KULeuven-COSIC/jitter_pipeline_trng/math_model/simulation_data/readme.md

# Stochastic Model Simulation Data

This folder contains the results from simulating the stochastic model.

## Folder structure:

- *m5/*: Contains jitter measurement simulation results.
- *h_vs_res_fnoise30.csv*: Contains simulated data capturing the resolution - entropy trade off.
