KULeuven-COSIC/jitter_pipeline_trng/math_model/simulation_data/m5/readme.md

# Jitter Measurement Simulation

Measurement *m5* is simulated for different jitter strength values.

## Data Format

| Column 0 | Column 1 | Column 2 | Column 3 | Column 4 | Column 5 | Column 6 | Column 7 | Column 8 | Column 9 | Column 10 |
| --- | --- | --- | --- | --- | --- | --- | --- | --- | --- | --- |
| DC0 configuration | DC1 configuration | VDL0 configuration | VDL1 configuration | DC0 period | DC1 period | VDL0 period | VDL1 period | Mean count | Variance count | Noise strength |
| Unit: - | Unit: - | Unit: - | Unit: - | Unit: ps | Unit: ps | Unit: ps | Unit: ps |  Unit: - | Unit: - | Unit: fs |
