KULeuven-COSIC/jitter_pipeline_trng/measurements/stat_tests/readme.md

# NIST SP800-90B IID Entropy Assessment

Statistical test results for different configurations and supply voltages.
