KULeuven-COSIC/jitter_pipeline_trng/measurements/m5/readme.md

# On-chip Jitter Measurement

Measure jitter strength experiment, using the TRNG hardware.

## Measurement Conditions:

The measurements are performed with:
- **Chip number**: 0, 1, 2, 3, 4, and 5

## Data Format

| Column 0 | Column 1 | Column 2 | Column 3 | Column 4 | Column 5 | Column 6 | Column 7 | Column 8 | Column 9 |
| --- | --- | --- | --- | --- | --- | --- | --- | --- | --- |
| DC0 configuration | DC1 configuration | VDL0 configuration | VDL1 configuration | DC0 period | DC1 period | VDL0 period | VDL1 period | Mean count | Variance count |
| Unit: - | Unit: - | Unit: - | Unit: - | Unit: ps | Unit: ps | Unit: ps | Unit: ps |  Unit: - | Unit: - |
