KULeuven-COSIC/jitter_pipeline_trng/measurements/m6/readme.md

# TRNG Configuration Optimization

Find an optimized configuration for the ASIC, within the constraints set by the stochastic model.

## Measurement Conditions:

The measurements are performed with the following operating conditions:
- **Temperature**: 20 °C
- **Supply voltage**: 0.8 V, 0.9 V, and 1.0 V
- **Chip number**: 0, 1, 2, 3, and 4

## Data Format

| Column 0 | Column 1 | Column 2 | Column 3 | Column 4 | Column 5 | Column 6 | Column 7 |
| --- | --- | --- | --- | --- | --- | --- | --- |
| DC0 configuration | DC1 configuration | VDL0 configuration | VDL1 configuration | DC0 period | DC1 period | VDL0 period | VDL1 period |
| Unit: - | Unit: - | Unit: - | Unit: - | Unit: ps | Unit: ps | Unit: ps | Unit: ps |
