KULeuven-COSIC/jitter_pipeline_trng/measurements/m7/readme.md

# Random Count Readout

Readout a small amount of random samples, using an optimized configuration.

## Measurement Conditions:

The measurements are performed with the following operating conditions:
- **Temperature**: 20 °C
- **Supply voltage**: 0.8 V, 0.9 V, and 1.0 V
- **Chip number**: 0, 1, 2, 3, and 4

## Data Format

A list of raw count values.
