KULeuven-COSIC/jitter_pipeline_trng/measurements/readout/readme.md

# Measurement scripts

This folder contains the following measurement scripts:
- **m0_read_freqs.py**: Read all RO frequencies.
- **m5_jitter_strength.py**: Measure jitter strength experiment.
- **m6_get_candidates.py**: Find an optimized configuration for the ASIC.
- **m7_read_bits.py**: Readout a small amount of random samples.
