KULeuven-COSIC/jitter_pipeline_trng/measurements/m0/readme.md

# RO Frequency Measurement

Read all RO frequencies.

## Measurement Conditions:

The measurements are performed with:
- **Chip number**: 0, 1, 2, 3, 4, and 5
- **Frequency scaler**: `conf_ro_sel = 0`

## Data Format

| Column 0 | Column 1 | Column 2 | Column 3 | Column 4 |
| --- | --- | --- | --- | --- |
| RO configuration | DC0 period | DC1 period | VDL0 period | VDL1 period |
| Unit: - | Unit: ns | Unit: ns | Unit: ps | Unit: ps |
