KULeuven-COSIC/jitter_pipeline_trng/measurements/stat_tests/iid_results.txt

NIST SP800-90B entropy assessment IID

| Chip | Conf                    | Temp | Supply | nb bits   | H_origi | H_bitst | ChiS | Leng | IIDP |

| 0000 | 17478 13892 44034 19462 | 0020 | 0000.9 | 001048576 | 4.71182 | 0.87548 | Fail | Pass | Fail |
| 0000 | 29038 18274 08802 03488 | 0020 | 0000.9 | 001048576 | 1.12625 | 0.16969 | Fail | Fail | Fail |
| 0000 | 41296 00786 33256 62592 | 0020 | 0000.9 | 001048576 | 7.56673 | 0.96453 | Pass | Pass | Pass |
| 0000 | 08910 62245 17569 35105 | 0020 | 0000.9 | 001048576 | 4.77728 | 0.93605 | Fail | Fail | Fail |
| 0000 | 53354 48800 12806 10786 | 0020 | 0000.9 | 001048576 | 7.49407 | 0.95119 | Pass | Pass | Pass |
| 0000 | 49365 02217 12592 38980 | 0020 | 0000.9 | 001048576 | 6.11269 | 0.83397 | Fail | Pass | Fail |
| 0000 | 00799 63233 60974 63709 | 0020 | 0000.9 | 001048576 | 1.79305 | 0.31232 | Fail | Fail | Fail |
| 0000 | 28937 16449 17486 00854 | 0020 | 0000.9 | 001048576 | 7.64800 | 0.98895 | Pass | Pass | Pass |
| 0000 | 24839 04290 12485 44416 | 0020 | 0000.9 | 001048576 | 7.46725 | 0.95524 | Pass | Pass | Fail |
| 0000 | 53387 02037 41664 19462 | 0020 | 0000.9 | 001048576 | 7.47545 | 0.94738 | Pass | Pass | Pass |
| 0000 | 13856 08215 00846 18954 | 0020 | 0000.9 | 001048576 | 7.56235 | 0.97071 | Pass | Pass | Fail |
| 0000 | 24928 24080 15168 24072 | 0020 | 0000.9 | 001048576 | 7.40528 | 0.93242 | Pass | Pass | Pass |
| 0000 | 07450 02472 25729 35168 | 0020 | 0000.9 | 001048576 | 7.17819 | 0.91466 | Pass | Pass | Pass |
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
| 0001 | 41231 04277 00160 00192 | 0020 | 0001.0 | 001048576 | 6.16136 | 0.81352 | Fail | Pass | Fail |
| 0001 | 57371 41487 00222 33536 | 0020 | 0001.0 | 001048576 | 7.49199 | 0.95877 | Pass | Pass | Pass |
