KULeuven-COSIC/jitter_pipeline_trng/measurements/m5/m5_chip0.csv

confDC0 | confDC1 | confVDL0 | confVDL1 | perDC0 [ps] | perDC1 [ps] | perVDL0 [ps] | perVDL1 [ps] | n | cntMean | cntVar
0 | 0 | 0 | 65376 | 18757.799530597058 | 18232.806588025815 | 448.8232224378738 | 171.2256470602989 | 1 | 9.10455322265625 | 0.10555421933531761
0 | 0 | 0 | 65376 | 18769.618513002635 | 18241.941769192228 | 448.4933426769447 | 171.1826217876485 | 2 | 12.397689819335938 | 0.2697450292762369
0 | 0 | 0 | 65376 | 18779.299673333713 | 18250.069618490674 | 448.5166701798282 | 171.20256636659542 | 4 | 18.779693603515625 | 0.31242700573056936
0 | 0 | 0 | 65376 | 18773.920018333905 | 18241.941769192228 | 448.4761555432682 | 171.21661085371608 | 8 | 31.723434448242188 | 0.6168556117918342
0 | 0 | 0 | 65376 | 18784.682412290756 | 18241.941769192228 | 448.44055781363335 | 171.21446377655175 | 1 | 9.17877197265625 | 0.150993462651968
0 | 0 | 0 | 65376 | 18779.299673333713 | 18240.92629703852 | 448.5516659845126 | 171.22591547706074 | 2 | 12.588897705078125 | 0.2447217097505927
0 | 0 | 0 | 65376 | 18788.990825688074 | 18255.153203342616 | 448.53631627504603 | 171.27057384632272 | 4 | 18.822372436523438 | 0.33794002584181726
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
