KULeuven-COSIC/jitter_pipeline_trng/measurements/m5/m5_chip1.csv

confDC0 | confDC1 | confVDL0 | confVDL1 | perDC0 [ps] | perDC1 [ps] | perVDL0 [ps] | perVDL1 [ps] | n | cntMean | cntVar
0 | 0 | 0 | 65376 | 17512.693068248624 | 17057.782404997397 | 386.87496458053914 | 155.5979752509568 | 1 | 9.517807006835938 | 0.2500491214450449
0 | 0 | 0 | 65376 | 17501.468781712334 | 17053.34374186833 | 386.6362247275859 | 156.00065508087582 | 2 | 13.903228759765625 | 0.22293513175100088
0 | 0 | 0 | 65376 | 17508.014533019876 | 17059.558517284466 | 386.5979077370313 | 155.41886208615483 | 4 | 20.602264404296875 | 0.3167209466919303
0 | 0 | 0 | 65376 | 17508.950040074807 | 17045.35996670828 | 386.680937484143 | 155.6908305474836 | 8 | 33.793304443359375 | 0.5805984800681472
0 | 0 | 0 | 65376 | 17502.403589360114 | 17056.894487533184 | 386.6585798132314 | 156.70513677028075 | 1 | 9.470779418945312 | 0.24939029826782644
0 | 0 | 0 | 65376 | 17502.403589360114 | 17056.006662502605 | 386.9571994728464 | 156.94005213773826 | 2 | 13.921539306640625 | 0.21845329459756613
0 | 0 | 0 | 65376 | 17516.437697118727 | 17065.77782407166 | 386.8092018282779 | 156.17076602218265 | 4 | 20.615768432617188 | 0.3138986953999847
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
