KULeuven-COSIC/jitter_pipeline_trng/measurements/m5/m5_chip2.csv

confDC0 | confDC1 | confVDL0 | confVDL1 | perDC0 [ps] | perDC1 [ps] | perVDL0 [ps] | perVDL1 [ps] | n | cntMean | cntVar
12288 | 12288 | 0 | 65376 | 15468.277945619335 | 15338.669662500584 | 433.08455114132744 | 174.68617741245032 | 1 | 7.030853271484375 | 0.04482444282621145
12288 | 12288 | 0 | 65376 | 15460.250058976173 | 15350.166299714245 | 432.74710152679114 | 175.06377636200935 | 2 | 7.3525238037109375 | 0.2584021387156099
12288 | 12288 | 0 | 65376 | 15463.898065125059 | 15351.604591239167 | 432.7071000252219 | 174.65954766972249 | 4 | 8.713409423828125 | 0.3275338103994727
12288 | 12288 | 0 | 65376 | 15466.087695284845 | 15345.853041727158 | 433.2689406410444 | 175.05563978541153 | 8 | 11.3651123046875 | 0.47081898152828217
12288 | 12288 | 0 | 65376 | 15469.008166926309 | 15345.134401048983 | 433.2477450438563 | 174.71728676338464 | 1 | 7.0687713623046875 | 0.07884288742206991
12288 | 12288 | 0 | 65376 | 15467.547793249942 | 15347.290525033957 | 433.04277037420775 | 175.02562516591593 | 2 | 7.3344879150390625 | 0.2555036989506334
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
