KULeuven-COSIC/jitter_pipeline_trng/measurements/m5/m5_chip3.csv

confDC0 | confDC1 | confVDL0 | confVDL1 | perDC0 [ps] | perDC1 [ps] | perVDL0 [ps] | perVDL1 [ps] | n | cntMean | cntVar
8192 | 1 | 0 | 61567 | 14661.297539149888 | 13975.348658677016 | 381.3092377422602 | 147.85395631612266 | 1 | 11.3209228515625 | 0.2179313749074936
8192 | 1 | 0 | 61567 | 14664.578205415082 | 13979.522184300342 | 381.4654896432259 | 147.9045427114539 | 2 | 15.593460083007812 | 0.2568291777279228
8192 | 1 | 0 | 61567 | 14666.547309999105 | 13990.265562291863 | 381.7227850106707 | 147.8270755249828 | 4 | 24.501144409179688 | 0.33450186415575445
8192 | 1 | 0 | 61567 | 14656.707071610681 | 13979.522184300342 | 381.4304106010835 | 147.68889061160544 | 8 | 42.205108642578125 | 0.836439966224134
8192 | 1 | 0 | 61567 | 14658.674062807551 | 13974.156680455457 | 381.3394127922336 | 147.7278413873289 | 1 | 11.359771728515625 | 0.23033603187650442
8192 | 1 | 0 | 61567 | 14662.609629497047 | 13978.32949407047 | 381.4472832590647 | 147.80480455827706 | 2 | 15.484664916992188 | 0.2553190344478935
8192 | 1 | 0 | 61567 | 14664.578205415082 | 13988.473852721452 | 381.4042165372157 | 147.61789993175015 | 4 | 24.514480590820312 | 0.3297463671769947
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
