KULeuven-COSIC/jitter_pipeline_trng/measurements/m5/m5_chip4.csv

confDC0 | confDC1 | confVDL0 | confVDL1 | perDC0 [ps] | perDC1 [ps] | perVDL0 [ps] | perVDL1 [ps] | n | cntMean | cntVar
8192 | 1 | 0 | 61671 | 15559.354226020892 | 14967.341159274654 | 431.8864189329896 | 172.2136294095976 | 1 | 10.434127807617188 | 0.24566085427068174
8192 | 1 | 0 | 61671 | 15562.310030395138 | 14976.234003656307 | 432.1461447362521 | 172.4889404521518 | 2 | 13.215484619140625 | 0.2055195039138198
8192 | 1 | 0 | 61671 | 15568.22500950209 | 14984.452167550759 | 431.83177959289105 | 172.7922817197599 | 4 | 19.580413818359375 | 0.30548430141061544
8192 | 1 | 0 | 61671 | 15556.399544246107 | 14975.549563548284 | 431.68614225302014 | 172.51963537537026 | 8 | 32.40142822265625 | 0.4923893176019192
8192 | 1 | 0 | 61671 | 15560.8319878431 | 14985.137421685646 | 431.75951753825393 | 172.3960141839494 | 1 | 10.26361083984375 | 0.1941201649606228
8192 | 1 | 0 | 61671 | 15562.310030395138 | 14983.081847279378 | 432.1444349930434 | 172.771054099569 | 2 | 13.2911376953125 | 0.22062824666500092
8192 | 1 | 0 | 61671 | 15566.745843230403 | 14992.67935578331 | 431.6474738453351 | 173.99837301326014 | 4 | 19.66510009765625 | 0.3168581686913967
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
