KULeuven-COSIC/jitter_pipeline_trng/measurements/m6/m6_chip0_temp20_sup0.9_0.csv

confDC0 [-] | confDC1 [-] | confVDL0 [-] | confVDL1 [-] | perDC0 [ps] | perDC1 [ps] | perVDL0 [ps] | perVDL1 [ps]
17593 | 07656 | 26338 | 23468 | 2236.7 | 2303.9 | 180.49 | 165.80
09974 | 13223 | 61252 | 31142 | 2237.2 | 2300.3 | 180.16 | 165.81
32067 | 39464 | 52840 | 07423 | 2231.3 | 2300.8 | 180.24 | 165.56
34915 | 13254 | 59104 | 37375 | 2236.3 | 2301.9 | 180.40 | 165.81
17802 | 42820 | 50398 | 47718 | 2238.8 | 2301.0 | 180.51 | 165.90
33748 | 11094 | 36212 | 48969 | 2236.7 | 2303.1 | 179.98 | 165.57
18250 | 61851 | 15526 | 57113 | 2237.6 | 2306.4 | 180.42 | 165.78
23605 | 07847 | 56355 | 23971 | 2236.8 | 2300.3 | 180.46 | 165.75
32067 | 15602 | 40049 | 63651 | 2231.1 | 2302.2 | 180.46 | 165.74
29773 | 23593 | 34291 | 52908 | 2233.9 | 2302.4 | 180.51 | 165.81
29813 | 43378 | 56482 | 32596 | 2235.0 | 2301.1 | 180.58 | 165.78
08185 | 14424 | 11686 | 55730 | 2237.6 | 2300.6 | 180.68 | 165.86
11597 | 09686 | 56343 | 59099 | 2239.8 | 2304.9 | 171.33 | 156.98
24388 | 48919 | 32530 | 54949 | 2230.0 | 2294.8 | 180.60 | 165.76
13438 | 24194 | 50727 | 36095 | 2240.3 | 2304.8 | 180.46 | 165.59
11597 | 10645 | 27701 | 54691 | 2240.2 | 2305.0 | 180.51 | 165.70
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
