KULeuven-COSIC/jitter_pipeline_trng/hardware/dc_branch/dc_branch.cir

* Top cell name: dc_branch

.SUBCKT nand2 in0 in1 out vdd vss
    Mm1 net9 in1 vss vss n_mos l=30n w=200n m=1 nf=1
    Mm0 out in0 net9 vss n_mos l=30n w=200n m=1 nf=1
    Mm3 out in1 vdd vdd p_mos l=30n w=100n m=1 nf=1
    Mm2 out in0 vdd vdd p_mos l=30n w=100n m=1 nf=1
.ENDS

.SUBCKT nand3_r in0 in1 in2 out rst vdd vss
    Mm3 out rst vss vss n_mos l=30n w=300n m=1 nf=1
    Mm2 net6 in2 vss vss n_mos l=30n w=300n m=1 nf=1
    Mm1 net7 in1 net6 vss n_mos l=30n w=300n m=1 nf=1
    Mm0 out in0 net7 vss n_mos l=30n w=300n m=1 nf=1
    Mm7 net21 rst vdd vdd p_mos l=30n w=200n m=1 nf=1
    Mm6 out in2 net21 vdd p_mos l=30n w=200n m=1 nf=1
    Mm5 out in1 net21 vdd p_mos l=30n w=200n m=1 nf=1
    Mm4 out in0 net21 vdd p_mos l=30n w=200n m=1 nf=1
.ENDS

.SUBCKT nand3 in0 in1 in2 out vdd vss
    Mm4 net016 in2 vss vss n_mos l=30n w=300n m=1 nf=1
    Mm1 net3 in1 net016 vss n_mos l=30n w=300n m=1 nf=1
    Mm0 out in0 net3 vss n_mos l=30n w=300n m=1 nf=1
    Mm5 out in2 vdd vdd p_mos l=30n w=100n m=1 nf=1
    Mm3 out in1 vdd vdd p_mos l=30n w=100n m=1 nf=1
    Mm2 out in0 vdd vdd p_mos l=30n w=100n m=1 nf=1
.ENDS

.SUBCKT inv_dh in out vdd vss
    Mm0 out in vss vss n_mos l=30n w=200n m=1 nf=1
    Mm1 out in vdd vdd p_mos l=30n w=100n m=1 nf=1
.ENDS

.SUBCKT dff_st_ar_dh clk q q' rst rst' vdd vss
    Xi5 q n1 q' vdd vss nand2
    Xi4 n0 q' q vdd vss nand2
    Xi2 n3 n0 n2 vdd vss nand2
    Xi6 clk n0 n3 n1 rst vdd vss nand3_r
    Xi7 clk n2 rst' n0 vdd vss nand3
    Xi8 n1 n3 vdd vss inv_dh
.ENDS

.SUBCKT first_edge edge out out' rst rst' vdd vss
    Xi0 edge out out' rst rst' vdd vss dff_st_ar_dh
.ENDS

.SUBCKT inv in out vdd vss
    Mm0 out in vss vss n_mos l=30n w=100n m=1 nf=1
    Mm1 out in vdd vdd p_mos l=30n w=100n m=1 nf=1
.ENDS

.SUBCKT mux2 in0 in1 out sel vdd vss
    Xi2 in0 net7 net9 vdd vss nand2
    Xi1 in1 sel net10 vdd vss nand2
    Xi0 net10 net9 out vdd vss nand2
    Xi3 sel net7 vdd vss inv
.ENDS

.SUBCKT mux4 in<0> in<1> in<2> in<3> out sel<0> sel<1> vdd vss
    Xi2 in<2> in<3> net5 sel<0> vdd vss mux2
    Xi1 in<0> in<1> net6 sel<0> vdd vss mux2
    Xi0 net6 net5 out sel<1> vdd vss mux2
.ENDS

.SUBCKT nor2 in0 in1 out vdd vss
    Mm1 out in1 vss vss n_mos l=30n w=100n m=1 nf=1
    Mm0 out in0 vss vss n_mos l=30n w=100n m=1 nf=1
    Mm3 net5 in1 vdd vdd p_mos l=30n w=200n m=1 nf=1
    Mm2 out in0 net5 vdd p_mos l=30n w=200n m=1 nf=1
.ENDS

.SUBCKT enable_n edge en rst rst' rst_glob rst_glob' start vdd vss
    Xi7 startl' edgel' edge_rst_loc' vdd vss nand2
    Xi8 edge_rst_loc' rst_glob' edge_rst vdd vss nand2
    Xi4 edgel startl en vdd vss nand2
    Xi9 edge_rst_loc rst_glob edge_rst' vdd vss nor2
    Xi5 startl edgel edge_rst_loc vdd vss nor2
    Xi2 edge edgel' edgel edge_rst edge_rst' vdd vss dff_st_ar_dh
    Xi0 start startl startl' rst rst' vdd vss dff_st_ar_dh
.ENDS

.SUBCKT dff_st_ar clk d q q' rst rst' vdd vss
    Xi5 q n1 q' vdd vss nand2
    Xi4 n0 q' q vdd vss nand2
    Xi3 n1 d n3 vdd vss nand2
    Xi2 n3 n0 n2 vdd vss nand2
    Xi6 clk n0 n3 n1 rst vdd vss nand3_r
    Xi7 clk n2 rst' n0 vdd vss nand3
.ENDS

.SUBCKT tff_st_ar clk q q' rst rst' vdd vss
    Xi8 clk q' q q' rst rst' vdd vss dff_st_ar
.ENDS

.SUBCKT freq_scaler_248 clk out<0> out<1> out<2> rst rst' vdd vss
    Xi2 out<1> net6 out<2> rst rst' vdd vss tff_st_ar
    Xi1 clk net9 out<0> rst rst' vdd vss tff_st_ar
    Xi0 out<0> net13 out<1> rst rst' vdd vss tff_st_ar
.ENDS

.SUBCKT inv_ch_2 conf conf' in out vdd vss
    Mm4 net12 in net015 vdd p_mos l=30n w=100n m=1 nf=1
    Mm2 net015 conf' vdd vdd p_mos l=30n w=100n m=1 nf=1
    Mm0 out in net12 vdd p_mos l=30n w=100n m=1 nf=1
    Mm5 net020 in net014 vss n_mos l=30n w=100n m=1 nf=1
    Mm3 net014 conf vss vss n_mos l=30n w=100n m=1 nf=1
    Mm1 out in net020 vss n_mos l=30n w=100n m=1 nf=1
.ENDS

.SUBCKT inv_ch_8 conf conf' in out vdd vss
    Mm13 net030 in net029 vdd p_mos l=30n w=100n m=1 nf=1
    Mm12 net031 in net030 vdd p_mos l=30n w=100n m=1 nf=1
    Mm11 net018 in net031 vdd p_mos l=30n w=100n m=1 nf=1
    Mm10 net021 in net018 vdd p_mos l=30n w=100n m=1 nf=1
    Mm7 net015 in net016 vdd p_mos l=30n w=100n m=1 nf=1
    Mm6 net016 in net021 vdd p_mos l=30n w=100n m=1 nf=1
    Mm4 net12 in net015 vdd p_mos l=30n w=100n m=1 nf=1
    Mm2 net029 conf' vdd vdd p_mos l=30n w=100n m=1 nf=1
    Mm0 out in net12 vdd p_mos l=30n w=100n m=1 nf=1
    Mm17 net019 in net035 vss n_mos l=30n w=100n m=1 nf=1
    Mm16 net035 in net037 vss n_mos l=30n w=100n m=1 nf=1
    Mm15 net037 in net036 vss n_mos l=30n w=100n m=1 nf=1
    Mm14 net036 in net014 vss n_mos l=30n w=100n m=1 nf=1
    Mm9 net027 in net019 vss n_mos l=30n w=100n m=1 nf=1
    Mm8 net017 in net027 vss n_mos l=30n w=100n m=1 nf=1
    Mm5 net020 in net017 vss n_mos l=30n w=100n m=1 nf=1
    Mm3 net014 conf vss vss n_mos l=30n w=100n m=1 nf=1
    Mm1 out in net020 vss n_mos l=30n w=100n m=1 nf=1
.ENDS

.SUBCKT inv_ch_4 conf conf' in out vdd vss
    Mm7 net015 in net016 vdd p_mos l=30n w=100n m=1 nf=1
    Mm6 net016 in net021 vdd p_mos l=30n w=100n m=1 nf=1
    Mm4 net12 in net015 vdd p_mos l=30n w=100n m=1 nf=1
    Mm2 net021 conf' vdd vdd p_mos l=30n w=100n m=1 nf=1
    Mm0 out in net12 vdd p_mos l=30n w=100n m=1 nf=1
    Mm9 net027 in net014 vss n_mos l=30n w=100n m=1 nf=1
    Mm8 net017 in net027 vss n_mos l=30n w=100n m=1 nf=1
    Mm5 net020 in net017 vss n_mos l=30n w=100n m=1 nf=1
    Mm3 net014 conf vss vss n_mos l=30n w=100n m=1 nf=1
    Mm1 out in net020 vss n_mos l=30n w=100n m=1 nf=1
.ENDS

.SUBCKT inv_ch_1 conf conf' in out vdd vss
    Mm2 net12 conf' vdd vdd p_mos l=30n w=100n m=1 nf=1
    Mm0 out in net12 vdd p_mos l=30n w=100n m=1 nf=1
    Mm3 net014 conf vss vss n_mos l=30n w=100n m=1 nf=1
    Mm1 out in net014 vss n_mos l=30n w=100n m=1 nf=1
.ENDS

.SUBCKT inv_ch_8l_mod in out vdd vss
    Mm58 int_p in net026 vdd p_mos l=30n w=100n m=1 nf=1
    Mm59 net026 in net047 vdd p_mos l=30n w=100n m=1 nf=1
    Mm60 net047 in net025 vdd p_mos l=30n w=100n m=1 nf=1
    Mm61 net025 in net050 vdd p_mos l=30n w=100n m=1 nf=1
    Mm62 net050 in net046 vdd p_mos l=30n w=100n m=1 nf=1
    Mm63 net046 in net028 vdd p_mos l=30n w=100n m=1 nf=1
    Mm64 net028 in net029 vdd p_mos l=30n w=100n m=1 nf=1
    Mm65 net029 in vdd vdd p_mos l=30n w=100n m=1 nf=1
    Mm13 net030 in int_p vdd p_mos l=30n w=100n m=1 nf=1
    Mm12 net031 in net030 vdd p_mos l=30n w=100n m=1 nf=1
    Mm11 net018 in net031 vdd p_mos l=30n w=100n m=1 nf=1
    Mm10 net021 in net018 vdd p_mos l=30n w=100n m=1 nf=1
    Mm7 net015 in net016 vdd p_mos l=30n w=100n m=1 nf=1
    Mm6 net016 in net021 vdd p_mos l=30n w=100n m=1 nf=1
    Mm4 net12 in net015 vdd p_mos l=30n w=100n m=1 nf=1
    Mm0 out in net12 vdd p_mos l=30n w=100n m=1 nf=1
    Mm66 net055 in vss vss n_mos l=30n w=100n m=1 nf=1
    Mm67 net056 in net055 vss n_mos l=30n w=100n m=1 nf=1
    Mm68 net033 in net056 vss n_mos l=30n w=100n m=1 nf=1
    Mm69 net032 in net033 vss n_mos l=30n w=100n m=1 nf=1
    Mm70 net061 in net032 vss n_mos l=30n w=100n m=1 nf=1
    Mm71 net059 in net061 vss n_mos l=30n w=100n m=1 nf=1
    Mm72 net057 in net059 vss n_mos l=30n w=100n m=1 nf=1
    Mm73 int_n in net057 vss n_mos l=30n w=100n m=1 nf=1
    Mm17 net019 in net035 vss n_mos l=30n w=100n m=1 nf=1
    Mm16 net035 in net037 vss n_mos l=30n w=100n m=1 nf=1
    Mm15 net037 in net036 vss n_mos l=30n w=100n m=1 nf=1
    Mm14 net036 in int_n vss n_mos l=30n w=100n m=1 nf=1
    Mm9 net027 in net019 vss n_mos l=30n w=100n m=1 nf=1
    Mm8 net017 in net027 vss n_mos l=30n w=100n m=1 nf=1
    Mm5 net020 in net017 vss n_mos l=30n w=100n m=1 nf=1
    Mm1 out in net020 vss n_mos l=30n w=100n m=1 nf=1
.ENDS

.SUBCKT dc_ch_4 conf'<0> conf'<1> conf'<2> conf'<3> conf'<4> conf'<5> conf'<6> conf'<7> conf'<8>
                + conf'<9> conf'<10> conf'<11> conf'<12> conf'<13> conf'<14> conf'<15> conf<0>
                + conf<1> conf<2> conf<3> conf<4> conf<5> conf<6> conf<7> conf<8> conf<9> conf<10>
                + conf<11> conf<12> conf<13> conf<14> conf<15> in int0 int1 int2 out vdd vss
    Xi60 conf<2> conf'<2> in int0 vdd vss inv_ch_2
    Xi61 conf<6> conf'<6> int0 int1 vdd vss inv_ch_2
    Xi62 conf<10> conf'<10> int1 int2 vdd vss inv_ch_2
    Xi63 conf<14> conf'<14> int2 out vdd vss inv_ch_2
    Xi48 conf<0> conf'<0> in int0 vdd vss inv_ch_8
    Xi51 conf<12> conf'<12> int2 out vdd vss inv_ch_8
    Xi49 conf<4> conf'<4> int0 int1 vdd vss inv_ch_8
    Xi50 conf<8> conf'<8> int1 int2 vdd vss inv_ch_8
    Xi56 conf<1> conf'<1> in int0 vdd vss inv_ch_4
    Xi59 conf<13> conf'<13> int2 out vdd vss inv_ch_4
    Xi57 conf<5> conf'<5> int0 int1 vdd vss inv_ch_4
    Xi58 conf<9> conf'<9> int1 int2 vdd vss inv_ch_4
    Xi67 conf<15> conf'<15> int2 out vdd vss inv_ch_1
    Xi66 conf<11> conf'<11> int1 int2 vdd vss inv_ch_1
    Xi65 conf<7> conf'<7> int0 int1 vdd vss inv_ch_1
    Xi64 conf<3> conf'<3> in int0 vdd vss inv_ch_1
    Xi76 in int0 vdd vss inv_ch_8l_mod
    Xi73 int0 int1 vdd vss inv_ch_8l_mod
    Xi74 int1 int2 vdd vss inv_ch_8l_mod
    Xi75 int2 out vdd vss inv_ch_8l_mod
.ENDS

.SUBCKT nand2_dnw in0 in1 out vdd vss
    Mm0 out in0 net9 vss n_mos l=30n w=200n m=1 nf=1
    Mm1 net9 in1 vss vss n_mos l=30n w=200n m=1 nf=1
    Mm3 out in1 vdd vdd p_mos l=30n w=100n m=1 nf=1
    Mm2 out in0 vdd vdd p_mos l=30n w=100n m=1 nf=1
.ENDS

.SUBCKT buf_wide in out vdd vss
    Mm1 out int vss vss n_mos l=30n w=200n m=4 nf=1
    Mm0 int in vss vss n_mos l=30n w=100n m=1 nf=1
    Mm3 out int vdd vdd p_mos l=30n w=200n m=4 nf=1
    Mm2 int in vdd vdd p_mos l=30n w=100n m=1 nf=1
.ENDS

.SUBCKT nand5 in0 in1 in2 in3 in4 out vdd vss
    Mm4 net21 in4 vss vss n_mos l=30n w=400n m=1 nf=1
    Mm3 net22 in3 net21 vss n_mos l=30n w=400n m=1 nf=1
    Mm2 net23 in2 net22 vss n_mos l=30n w=400n m=1 nf=1
    Mm1 net24 in1 net23 vss n_mos l=30n w=400n m=1 nf=1
    Mm0 out in0 net24 vss n_mos l=30n w=400n m=1 nf=1
    Mm9 out in0 vdd vdd p_mos l=30n w=100n m=1 nf=1
    Mm8 out in4 vdd vdd p_mos l=30n w=100n m=1 nf=1
    Mm7 out in3 vdd vdd p_mos l=30n w=100n m=1 nf=1
    Mm6 out in1 vdd vdd p_mos l=30n w=100n m=1 nf=1
    Mm5 out in2 vdd vdd p_mos l=30n w=100n m=1 nf=1
.ENDS

.SUBCKT dc_rst_check dc_in int0 int1 int2 muxin0 out vdd vss
    Xi0 dc_in int0' int1 int2' muxin0 out vdd vss nand5
    Xi2 int2 int2' vdd vss inv
    Xi1 int0 int0' vdd vss inv
.ENDS

.SUBCKT dc_branch conf_dc'<0> conf_dc'<1> conf_dc'<2> conf_dc'<3> conf_dc'<4> conf_dc'<5>
                  + conf_dc'<6> conf_dc'<7> conf_dc'<8> conf_dc'<9> conf_dc'<10> conf_dc'<11>
                  + conf_dc'<12> conf_dc'<13> conf_dc'<14> conf_dc'<15> conf_dc<0> conf_dc<1>
                  + conf_dc<2> conf_dc<3> conf_dc<4> conf_dc<5> conf_dc<6> conf_dc<7> conf_dc<8>
                  + conf_dc<9> conf_dc<10> conf_dc<11> conf_dc<12> conf_dc<13> conf_dc<14>
                  + conf_dc<15> conf_enhigh conf_freqsel<0> conf_freqsel<1> dc_rst out out_raw rst
                  + rst' rst_glob rst_glob' start vdd vdd_dc vss vss_dc
    Xi4 mux_out out net19 rst rst' vdd vss first_edge
    Xi3 muxin<0> muxin<1> muxin<2> muxin<3> mux_out conf_freqsel<0> conf_freqsel<1> vdd vss mux4
    Xi5 out enable' rst rst' rst_glob rst_glob' start vdd vss enable_n
    Xi7 enable' conf_enhigh' enable vdd vss nand2
    Xi2 muxin<0> muxin<1> muxin<2> muxin<3> enable' enable vdd vss freq_scaler_248
    Xi1 conf_dc'<0> conf_dc'<1> conf_dc'<2> conf_dc'<3> conf_dc'<4> conf_dc'<5> conf_dc'<6>
        + conf_dc'<7> conf_dc'<8> conf_dc'<9> conf_dc'<10> conf_dc'<11> conf_dc'<12> conf_dc'<13>
        + conf_dc'<14> conf_dc'<15> conf_dc<0> conf_dc<1> conf_dc<2> conf_dc<3> conf_dc<4>
        + conf_dc<5> conf_dc<6> conf_dc<7> conf_dc<8> conf_dc<9> conf_dc<10> conf_dc<11> conf_dc<12>
        + conf_dc<13> conf_dc<14> conf_dc<15> dc_in dc_int0 dc_int1 dc_int2 muxin<0> vdd_dc vss_dc
        + dc_ch_4
    Xi6 conf_enhigh conf_enhigh' vdd vss inv
    Xi8 enable muxin<0> dc_in vdd_dc vss_dc nand2_dnw
    Xi9 muxin<0> out_raw vdd vss buf_wide
    Xi10 dc_in dc_int0 dc_int1 dc_int2 muxin<0> dc_rst vdd vss dc_rst_check
.ENDS
